2row-unb/2re-electronic/Kernel.md

## Kernel

### 2R-Kernel
O kernel do projeto será um microprocessador Raspberry-Pi que será intermediador das informações trocas pelo sistema.
Para que os dados transitem e sejam trabalhados pelo dispositivo kernel, o gerenciamento de todo o processo ocorre com o uso do protocolo de comunicação MQTT. Nesse contexto a título de simplificação o Raspberry-Pi aplicado como kernel será visto dentro do protocolo MQTT, como um Broker e os dispositivos em comunicação poderão fazer publicações e leituras referentes a transmissão de dados pelo Kernel. 

## MQTT
O MQTT(Message Queuing Telemetry Transport) é um protocolo de comunicação via troca de mensagens classificado em M2M(machine to machine). Ele será aplicado ao projeto por questões de viabilidade, pois é levado em conta a sua necessidade de pouquissíma banda, a sua base em TCP/IP e por possuir um payload que carrega a mensagem menor que HTTP.

As mensagens enviadas ao Broker são publicações por parte dos clientes. Assim como o kernel, que nessa situação é o broker, vai encaminhar dados e está fazendo publicações.
Entretando a parte do Kernel funciona de maneira mais interessante pelo fato de não só publicar, mas também subscrever, isso ocorre, pois o broker do caso atua como mediador, recebendo informações e respondendo às mesmas. Em termos simples, o dispositivo que solicita a informação é nomeado de subscriber.

### Publish/subscribe
O padrão publish/subscribe é uma alternativa ao tradicional modelo cliente-servidor, mas o cliente comunica diretamente com o endpoint. Todavia, Pub/Sub desacopla um cliente que envia uma mensagem particular(chamado publisher) de outro cliente(ou mais clientes), os quais estão recebendo a mensagem(chamado subscriber). Isso significa que tanto o publisher quanto o subscriber, não sabem da existência um do outro. O terceiro componente existente nesse protocolo é o broker(no projeto será o kernel). Já o broker é conhecido tanto pelo publisher quanto pelo subscriber. O broker é crucial pois é o responsável por filtrar todas as mensagens chegadas e distribui cada uma delas.

## Aplicação no projeto
O kernel farrá boa parte da comunicação com a parte de software. Serão enviadas informações recebidas das IMU's, também as recebidas acerca dos dados de potência. Todas essa informações vão ser passadas ao software para que a análise seja feita e a decisão seja tomada pelo kernel.
A escolha pelo MQTT foi com base na facilidade em utilizar um protocolo da camada de aplicação cuja velocidade de envio das mensagens serão sufientes em uma rede local. O projeto fica robusto ao utilizar um protocolo confiável e com uma certa mobilidade para o envio ordenado de mensagens. Além disso o protocolo MQTT possui um buffer suficiente para organizar as mensagens em termos de um tempo no kernel do projeto e transparecer a transição de dados em tempo real.  
O projeto envolve uma topogia ideal para o uso do protocolo, pois o kernel necessita julgar informações e divisão correta do envio das mensagens[@fig:Modelo_broker_MQTT], algo que um servidor poderia trazer complicações. Além da base do MQTT é ser usado para comunicação entre máquinas e não por envio à base de solicitações de clientes, como ocorre no servidor. A aplicação também é bem colocada por se tratar de clientes mandando informaçẽos de sensores, o que traz a ideia de IoT, o que não deixa de ser parte do projeto.

A taxa de envio no kernel é de 34.4kbps. Essa é uma informação tida como base a taxa de transmissão do módulo Wifi, ESP8266.

Celula_s^[Fonte: ]

## Integração dos sensores do projeto

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

Celula_s^[Fonte: ]

## Integração eletrônica com software
A troca de informação entre Eletrônica e software é bastante importante para o correto funcionamento do projeto. Essa relevância se dá pelo fato de ocorrer a troca de várias informações referentes ao desenvolvimento do atleta.
Será entregue a parte de software os dados referêntes as IMU's, um tempo de ciclo, a potência desenvolvida pelo atleta e os estados dos botôes. A interação entre esses dados entregues tratá como retorno as ações que o kernel deverá delegar aos dispositivos as tarefas relacionadas ao movimento.

O vetor enviado como uma mensagem para software tem o seguinte formato:
vetor[]=(accelx1, accely1, accelz1, girox1, giroy1, giroz1, magnx1, magny1, magnz1, accelx2, accely2, accelz2, girox2, giroy2, giroz2, magnx2, magny2, magnz2, pot, t, estado 1,estado2,estado3)

### Paho Client
Toda a comuniação entre o Kernel e a parte de software será feita usando o paho client. Ele já tem métodos especificos para que essa comunicação eficiente.
