2row-unb/2re-electronic/(commit log)

2018-06-07 Adicionado arquivo de leitura da esp
2018-06-08 Adicionando o codigo de teste de botoes
2018-06-08 Adicionando codigo de controlar a carga
2018-06-12 Codigo de leitura e envio de dados ESP-2 IMUs
2018-06-12 Codigo de leitura e envio de dados ESP-2 IMUs- giro em rad
